Longhorn-Rocketry-Electronics/Polaris/chronos-polaris-hardware/chronos-polaris-hardware.step

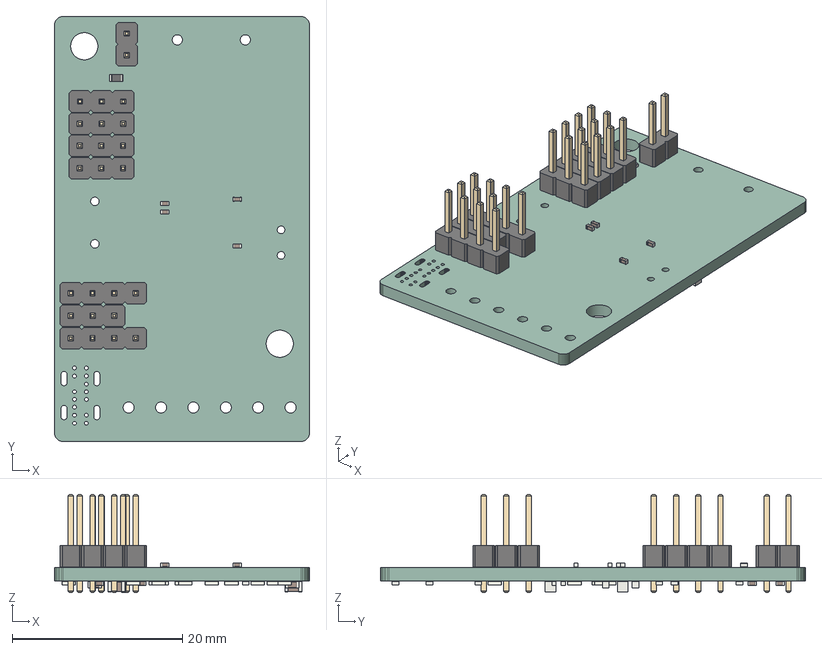
[picture p1: CAD file, 2023-10-29]
chronos-polaris-hardware/chronos-polaris-hardware.step
30.0 x 50.0 x 11.5 mm
chronos-polaris-hardware PCB
