Longhorn-Rocketry-Electronics/Polaris/Flight Data/Drone Polaris Test.csv

time_us | pressure_pa | temp | altitude | fakeYaw | fakePitch | fakeRoll | ax | ay | az | wx | wy | wz | cont_drogue | cont_main | state | fired_main_us | fired_drogue_us
4939285 | 97548 | 22.32 | 319.26 | 180 | 0 | 0 | 84.96 | 48.34 | -1004.88 | 0.18 | -0.37 | 0.18 | 0 | 0 | 0 | 0 | 0
4951188 | 97548 | 22.32 | 319.26 | 180 | -0.07 | 0.04 | 85.69 | 52 | -1007.81 | 0.06 | -0.31 | 0.18 | 0 | 0 | 0 | 0 | 0
4961191 | 97548 | 22.32 | 319.26 | 180 | -0.12 | 0.07 | 85.69 | 50.54 | -1004.88 | 0.12 | -0.18 | 0.12 | 0 | 0 | 0 | 0 | 0
4971191 | 97548 | 22.32 | 319.26 | 180.01 | -0.17 | 0.1 | 86.43 | 52.73 | -1003.42 | 0.12 | -0.06 | 0.18 | 0 | 0 | 0 | 0 | 0
4981195 | 97548 | 22.32 | 319.26 | 180.01 | -0.22 | 0.13 | 85.69 | 49.8 | -1004.88 | 0.24 | 0.12 | 0.31 | 0 | 0 | 0 | 0 | 0
4991193 | 97548 | 22.32 | 319.26 | 180.01 | -0.26 | 0.16 | 84.96 | 50.54 | -1008.54 | 0.12 | 0 | 0.12 | 0 | 0 | 0 | 0 | 0
5001410 | 97548 | 22.32 | 319.26 | 180.01 | -0.32 | 0.19 | 84.96 | 52 | -1007.08 | 0.06 | -0.12 | 0.12 | 636 | 634 | 0 | 0 | 0
5011409 | 97548 | 22.32 | 319.26 | 180.01 | -0.37 | 0.22 | 83.5 | 52 | -1004.88 | 0.12 | -0.12 | 0.24 | 636 | 634 | 0 | 0 | 0
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
