Longhorn-Rocketry-Electronics/Polaris/chronos-polaris-hardware/chronos-polaris-hardware.kicad_pcb

## KiCad design chronos-polaris-hardware/chronos-polaris-hardware.kicad_pcb (2024-10-20)

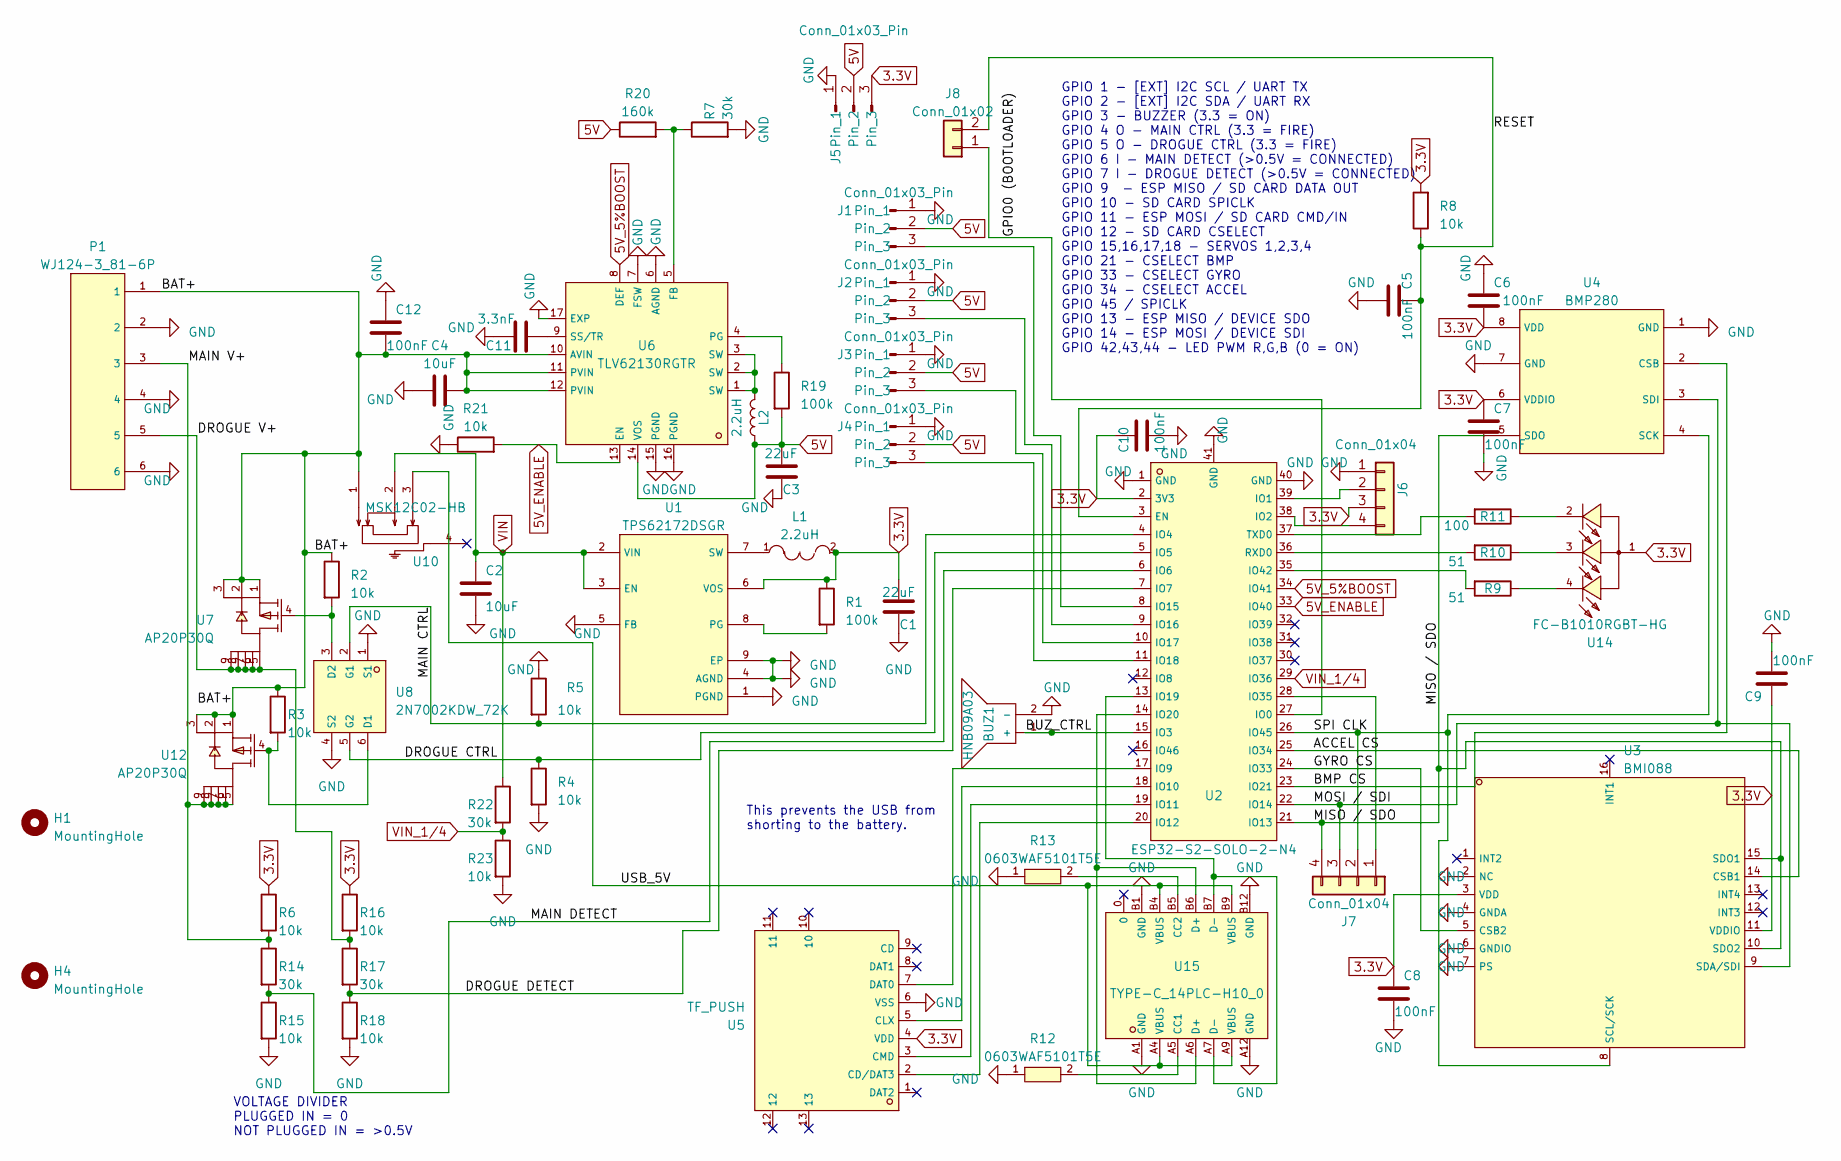
[picture p2: schematic chronos-polaris-hardware.kicad_sch]

Parts:
BUZ1: HNB09A03; BUZ-TH_BD9.0-P5.00-D0.6-FD; LCSC C96102
C1, C3: 22uF; C_0603_1608Metric
C2, C4: 10uF; C_0805_2012Metric
C5, C6, C7, C8, C9, C10, C12: 100nF; C_0402_1005Metric
C11: 3.3nF; C_0402_1005Metric
H1, H4: MountingHole; MountingHole_3.2mm_M3_Pad
J1, J2, J3, J4, J5: Conn_01x03_Pin; PinHeader_1x03_P2.54mm_Vertical
J6, J7: Conn_01x04; PinHeader_1x04_P2.54mm_Vertical
J8: Conn_01x02; PinHeader_1x02_P2.54mm_Vertical
L1: 2.2uH; IND-SMD_L3.0-W3.0; LCSC C43389
L2: 2.2uH; IND-SMD_L4.0-W4.0
P1: WJ124-3_81-6P; CONN-TH_6P-P3.81_WJ124-3.81-6P; LCSC C69810
R1, R19: 100k; R_0603_1608Metric
R2, R3, R4, R5, R6, R8, R15, R16, R18, R21, R23: 10k; R_0603_1608Metric
R7, R14, R17, R22: 30k; R_0603_1608Metric
R9, R10: 51; R_0603_1608Metric
R11: 100; R_0603_1608Metric
R12, R13: 0603WAF5101T5E; R0603; LCSC C23186
R20: 160k; R_0603_1608Metric
U1: TPS62172DSGR; WSON-8_L2.0-W2.0-P0.50-TL-EP; LCSC C59873
U2: ESP32-S2-SOLO-2-N4; WIRELM-SMD_ESP32-S3-WROOM-1; LCSC C3040594
U3: BMI088; LGA-16_L4.5-W3.0-P0.50-BL; LCSC C194919
U4: BMP280; LGA-8_L2.5-W2.0-P0.65_AMP6127; LCSC C83291
U5: TF_PUSH; TF-SMD_TF-PUSH; LCSC C393941
U6: TLV62130RGTR; QFN-16_L3.0-W3.0-P0.50-TL-EP; LCSC C122479
U7, U12: AP20P30Q; DFN-8_L3.3-W3.0-P0.65-LS3.3-BL-EP; LCSC C2837278
U8: 2N7002KDW_72K; SOT-363_L2.1-W1.3-P0.65-LS2.3-BL; LCSC C2919800
U10: MSK12C02-HB; SW-TH_MSK12C02-HB-1; LCSC C431541
U14: FC-B1010RGBT-HG; LED-ARRAY-SMD_4P-L1.0-W1.0-TR-RD; LCSC C158099
U15: TYPE-C_14PLC-H10_0; USB-C-TH_SHOUHAN_TYPE-C-14PLC-H10.0; LCSC C3151746

Connections:
3.3V: C1.1, C6.1, C7.1, C8.1, C9.1, C10.1, J5.3, J6.3, L1.2, R1.1, R6.1, R8.2, R16.1, U1.6 (VOS), U2.2 (3V3), U3.3 (VDD), U3.11 (VDDIO), U4.6 (VDDIO), U4.8 (VDD), U5.4 (VDD), U14.1 (+)
5V: C3.1, J1.2, J2.2, J3.2, J4.2, J5.2, L2.1, R19.2, R20.1, U6.14 (VOS)
5V_5%BOOST: U2.34 (IO41), U6.8 (DEF)
5V_ENABLE: R21.2, U2.33 (IO40), U6.13 (EN)
/ACCEL CS: U2.25 (IO34), U3.14 (CSB1)
/BAT+: C4.1, C12.2, P1.1, R2.1, R3.1, U6.10 (AVIN), U6.11 (PVIN), U6.12 (PVIN), U7.1 (S), U7.2 (S), U7.3 (S), U10.1, U12.1 (S), U12.2 (S), U12.3 (S)
/BMP CS: U2.23 (IO21), U4.2 (CSB)
/BUZ_CTRL: BUZ1.1 (+), U2.15 (IO3)
/DROGUE CTRL: R4.1, U2.5 (IO5), U8.5 (G2)
/DROGUE DETECT: R17.2, R18.1, U2.7 (IO7)
/DROGUE V+: P1.5, R16.2, R17.1, U7.5 (D), U7.6 (D), U7.7 (D), U7.8 (D), U7.9 (D)
/GPIO0 (BOOTLOADER): J8.1, U2.27 (IO0)
/GYRO CS: U2.24 (IO33), U3.5 (CSB2)
/MAIN CTRL: R5.2, U2.4 (IO4), U8.2 (G1)
/MAIN DETECT: R14.2, R15.1, U2.6 (IO6)
/MAIN V+: P1.3, R6.2, R14.1, U12.5 (D), U12.6 (D), U12.7 (D), U12.8 (D), U12.9 (D)
/MISO / SDO: J7.4, U2.21 (IO13), U3.10 (SDO2), U3.15 (SDO1), U4.5 (SDO)
/MOSI / SDI: J7.3, U2.22 (IO14), U3.9 (SDA/SDI), U4.3 (SDI)
/RESET: C5.1, J8.2, R8.1, U2.3 (EN)
/SPI CLK: J7.2, U2.26 (IO45), U3.8 (SCL/SCK), U4.4 (SCK)
/USB_5V: U10.3, U15.A4 (VBUS), U15.A9 (VBUS), U15.B4 (VBUS), U15.B9 (VBUS)
GND: BUZ1.2 (-), C1.2, C2.2, C3.2, C4.2, C5.2, C6.2, C7.2, C8.2, C9.2, C10.2, C11.1, C12.1, J1.1, J2.1, J3.1, J4.1, J5.1, J6.1, P1.2, P1.4, P1.6, R4.2, R5.1, R7.2, R12.1, R13.1, R15.2, R18.2, R21.1, R23.2, U1.1 (PGND), U1.4 (AGND), U1.5 (FB), U1.9 (EP), U2.1 (GND), U2.40 (GND), U2.41 (GND), U3.2 (NC), U3.4 (GNDA), U3.6 (GNDIO), U3.7 (PS), U4.1 (GND), U4.7 (GND), U5.6 (VSS), U6.6 (AGND), U6.7 (FSW), U6.15 (PGND), U6.16 (PGND), U6.17 (EXP), U8.1 (S1), U8.4 (S2), U15.A1 (GND), U15.A12 (GND), U15.B1 (GND), U15.B12 (GND)
unnamed: J1.3, U2.8 (IO15)
unnamed: J2.3, U2.9 (IO16)
unnamed: J3.3, U2.10 (IO17)
unnamed: J4.3, U2.11 (IO18)
unnamed: J6.2, U2.39 (IO1)
unnamed: J6.4, U2.38 (IO2)
unnamed: J7.1, U2.28 (IO35)
unnamed: L2.2, U6.1 (SW), U6.2 (SW), U6.3 (SW)
unnamed: R9.1, U14.4 (-)
unnamed: R10.1, U14.3 (-)
unnamed: R11.1, U14.2 (-)
unnamed: R1.2, U1.8 (PG)
unnamed: L1.1, U1.7 (SW)
unnamed: U2.17 (IO9), U5.7 (DAT0)
unnamed: U2.18 (IO10), U5.5 (CLX)
unnamed: U2.19 (IO11), U5.3 (CMD)
unnamed: U2.20 (IO12), U5.2 (CD/DAT3)
unnamed: U2.13 (IO19), U15.A7 (D-), U15.B7 (D-)
unnamed: U2.14 (IO20), U15.A6 (D+), U15.B6 (D+)
unnamed: R9.2, U2.35 (IO42)
unnamed: R10.2, U2.36 (RXD0)
unnamed: R11.2, U2.37 (TXD0)
unnamed: R7.1, R20.2, U6.5 (FB)
unnamed: R19.1, U6.4 (PG)
unnamed: C11.2, U6.9 (SS/TR)
unnamed: R2.2, U7.4 (G), U8.3 (D2)
unnamed: R3.2, U8.6 (D1), U12.4 (G)
unnamed: R12.2, U15.A5 (CC1)
unnamed: R13.2, U15.B5 (CC2)
VIN: C2.1, R22.1, U1.2 (VIN), U1.3 (EN), U10.2
VIN_1/4: R22.2, R23.1, U2.29 (IO36)

Notes on the sheet:
This prevents the USB from shorting to the battery.
VOLTAGE DIVIDER PLUGGED IN = 0 NOT PLUGGED IN = >0.5V
GPIO 1 - [EXT] I2C SCL / UART TX GPIO 2 - [EXT] I2C SDA / UART RX GPIO 3 - BUZZER (3.3 = ON) GPIO 4 O - MAIN CTRL (3.3 = FIRE) GPIO 5 O - DROGUE CTRL (3.3 = FIRE) GPIO 6 I - MAIN DETECT (>0.5V = CONNECTED) GPIO 7 I - DROGUE DETECT (>0.5V = CONNECTED) GPIO 9 - ESP MISO / SD CARD DATA OUT GPIO 10 - S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

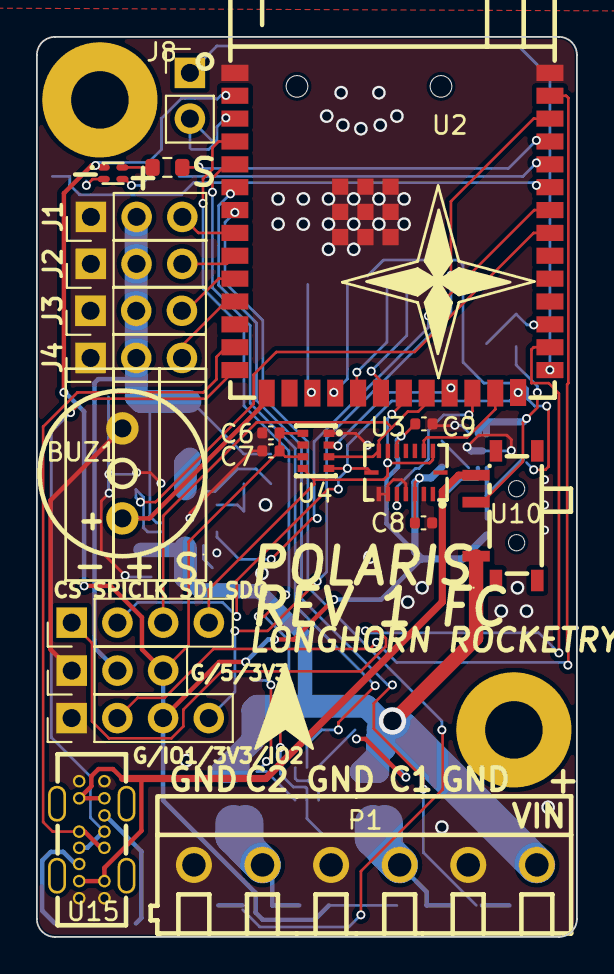
[picture p3: board chronos-polaris-hardware.kicad_pcb from above]

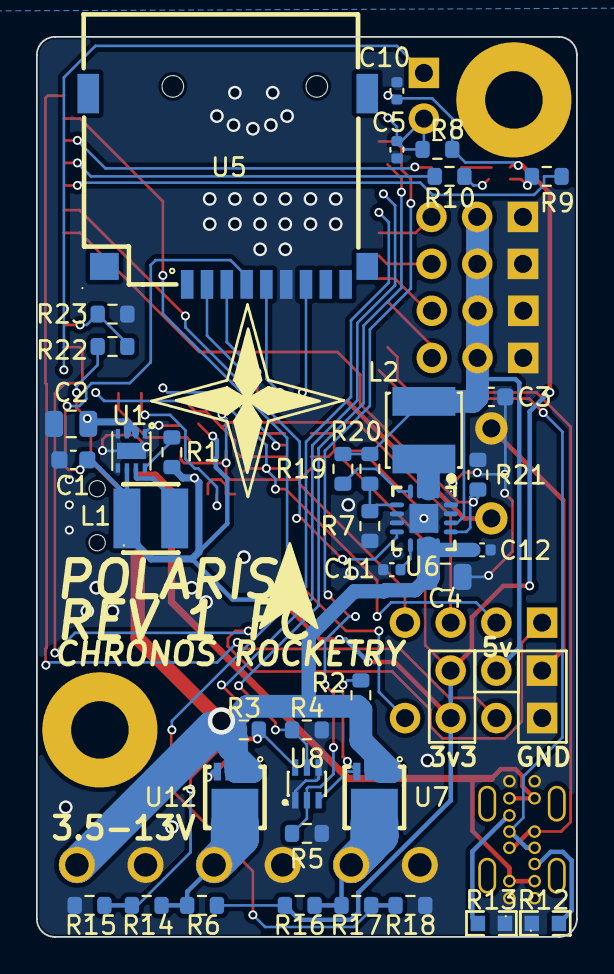
[picture p4: board chronos-polaris-hardware.kicad_pcb from below]

Board: 2 copper layers, 30.0 x 50.0 mm, 61 parts (38 on the bottom side), 53 nets.
