Longhorn-Rocketry-Electronics/Polaris/(commit log)

2023-07-01 add symbols and footprints
    [chronos-polaris-hardware.kicad_pcb, chronos-polaris-hardware.kicad_sch]
2023-07-02 mainly finish schematic
    [chronos-polaris-hardware.kicad_sch]
2023-07-03 checkpoint, mcu needs to be replaced
    [chronos-polaris-hardware.kicad_sch]
2023-07-04 finish schematic for real, start pcb
    [chronos-polaris-hardware.kicad_pcb, chronos-polaris-hardware.kicad_sch]
2023-07-04 convert ematch detect to voltage divider
    [chronos-polaris-hardware.kicad_sch]
2023-07-06 finish PCB layout
    [chronos-polaris-hardware.kicad_pcb, chronos-polaris-hardware.kicad_sch]
2023-07-06 improve ground planes
    [chronos-polaris-hardware.kicad_pcb, chronos-polaris-hardware.kicad_sch]
2023-07-12 switch to compact 5v regulator
    [BOM-chronos-polaris-hardware.csv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]
2023-07-12 fix V in switching with usb, remove diode
    [chronos-polaris-hardware.kicad_pcb, chronos-polaris-hardware.kicad_sch]
2023-07-12 polaris routing with fix V
    [chronos-polaris-hardware.kicad_pcb, chronos-polaris-hardware.kicad_sch]
2023-07-12 minor fixes
    [chronos-polaris-hardware.kicad_pcb]
2023-07-29 random qol updates?
    [BOM-chronos-polaris-hardware.csv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]
2023-08-01 add some firmware
    [chronos-polaris-hardware.kicad_sch]
2023-08-07 quaternion integration post processor
    added gyroToAngle.m and ROCKcopy version, both are the same
    [gyro10.csv, gyro10Beuler.csv, gyro10Ceuler.csv, gyro10euler.csv, gyro19.csv, gyro19euler.csv]
2023-09-25 fix massive logging bug
    [bmp.cpp, circularbuffer.h, main.cpp]
2023-10-15 fix altitudes not being relative to each other
    [circularbuffer.h, main.cpp]
2023-10-29 switch detect bufs to uint16_t
    [chronos-polaris-hardware.step]
2023-11-14 switched altitude based deployment to use median altitude to avoids spikes
    [main.cpp, util.cpp, util.h]
2024-03-06 Add template servo code
2024-03-06 Ignore kicad zip backups
2024-08-27 Improve orientation tracking; add servo support, fake TVC
    [chronos-polaris-hardware.kicad_pcb]
2024-10-20 update version
    [chronos-polaris-hardware.kicad_pcb, chronos-polaris-hardware.kicad_sch]
2025-02-17 MATLAB polaris alt and state analysis code, some polaris datasets
    [Polaris AVTR FTE1 Raw.csv, Polaris AVTR FTE2 Raw.csv, TRA_Failed_Polaris.csv]
2025-02-17 added drone data
    [Drone Polaris Test.csv]
